felipe-m/oscad_filter_stage/imgs/filter_holder2.png

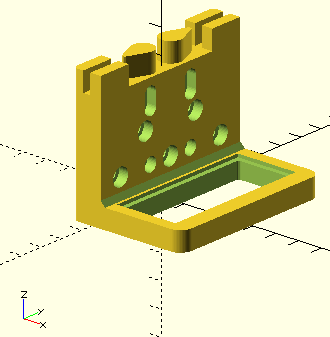
imgs/filter_holder2.png
