felipe-m/oscad_filter_stage/imgs/filter_holder.png

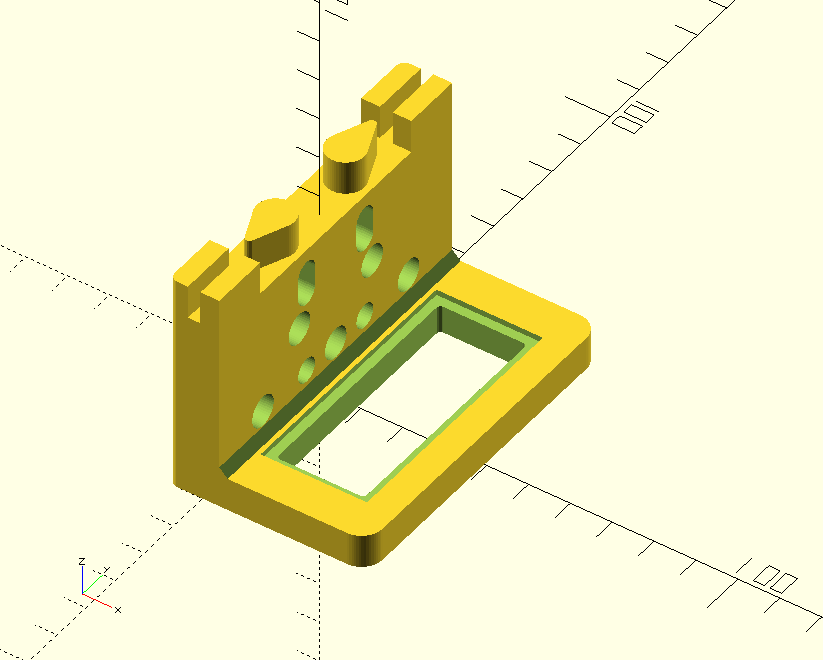
imgs/filter_holder.png
