felipe-m/oscad_filter_stage/imgs/idler_tensioner.png

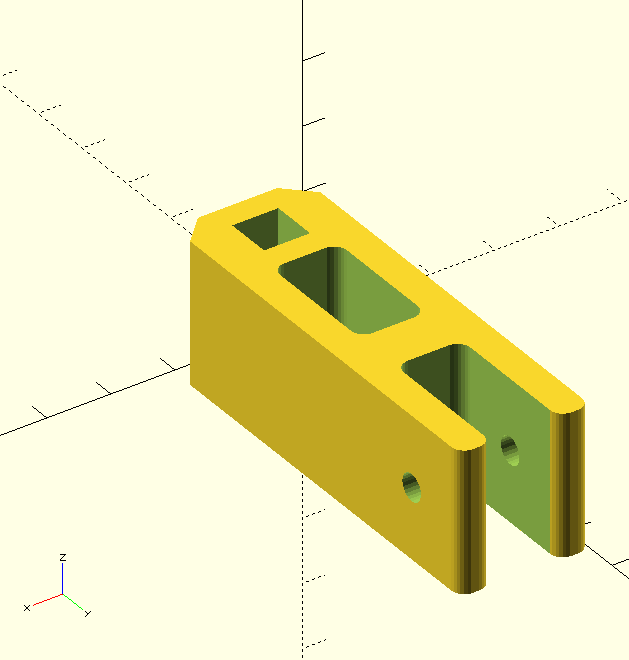
imgs/idler_tensioner.png
