felipe-m/oscad_filter_stage/imgs/idler_tensioner_optional.png

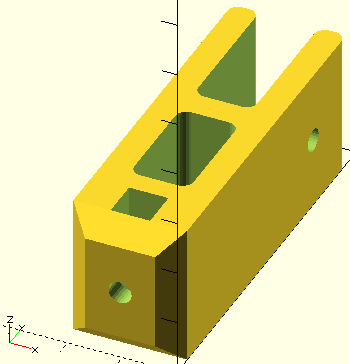
imgs/idler_tensioner_optional.png
