felipe-m/oscad_filter_stage/imgs/nema17holder.png

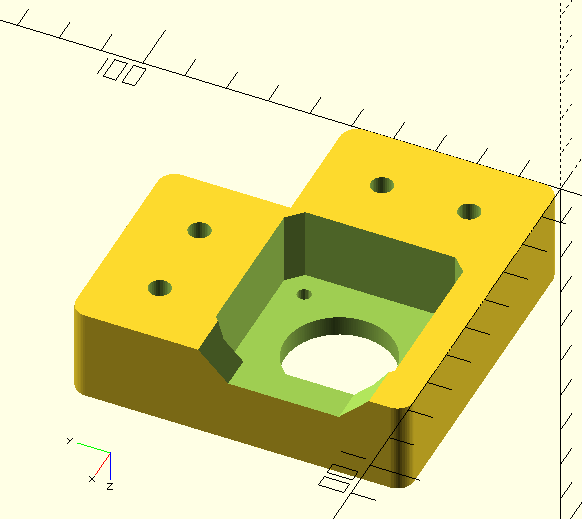
imgs/nema17holder.png
