felipe-m/oscad_filter_stage/imgs/small/nema17holder.png

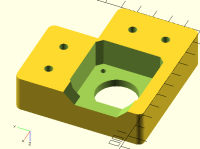
imgs/small/nema17holder.png
