felipe-m/oscad_filter_stage/imgs/tens_holder.png

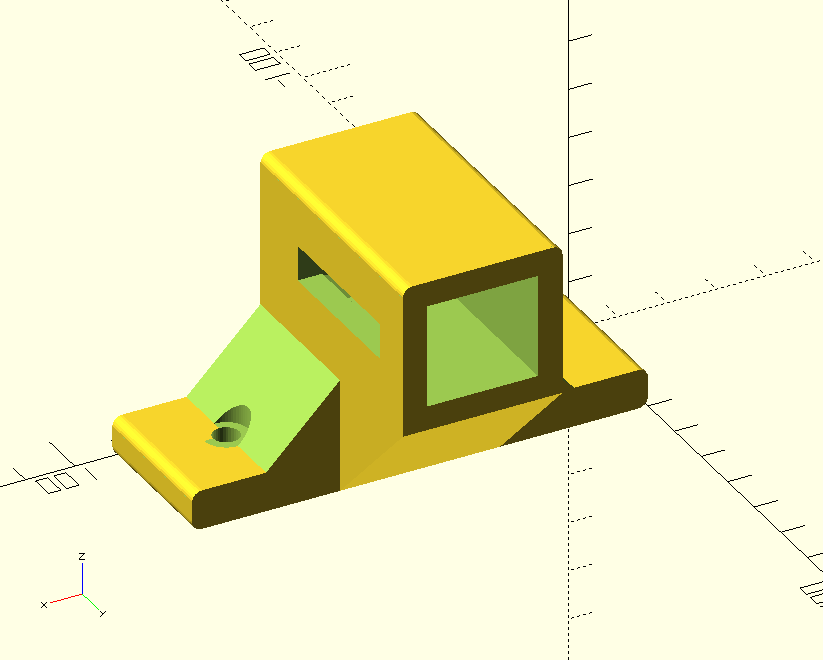
imgs/tens_holder.png
