felipe-m/oscad_filter_stage/stl/nemamotor_holder.stl

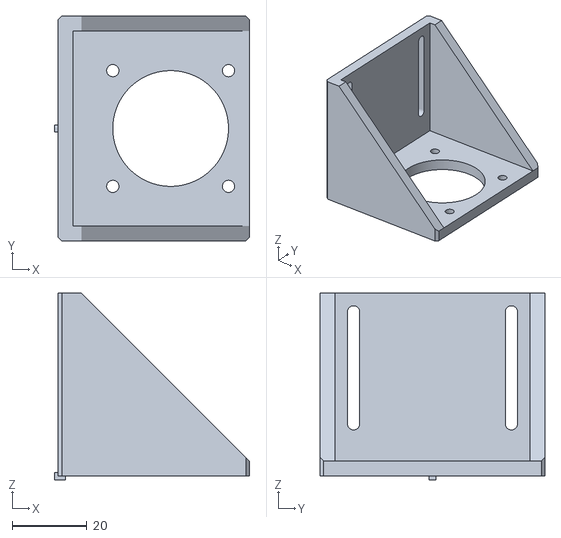
[picture p39: CAD file, 2019-07-27]
stl/nemamotor_holder.stl
52.3 x 60.3 x 50.0
