felipe-m/oscad_filter_stage/stl/idler_tensioner.stl

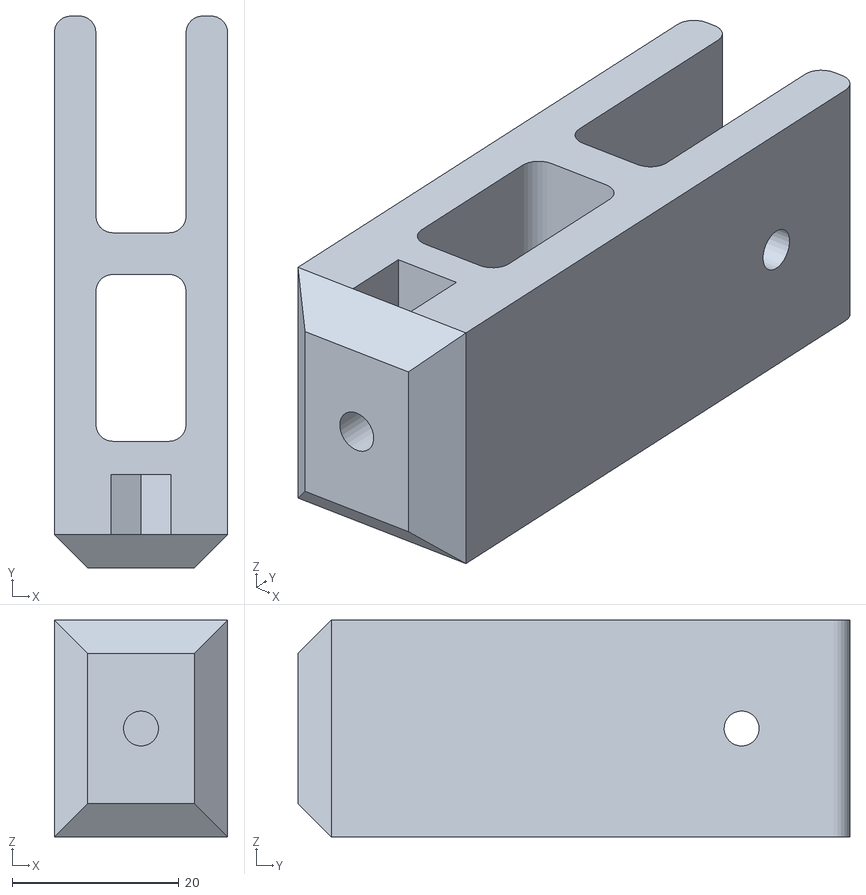
[picture p40: CAD file, 2017-12-09]
stl/idler_tensioner.stl
20.8 x 66.2 x 26.0
