felipe-m/oscad_filter_stage/stl/idler_holder.stl

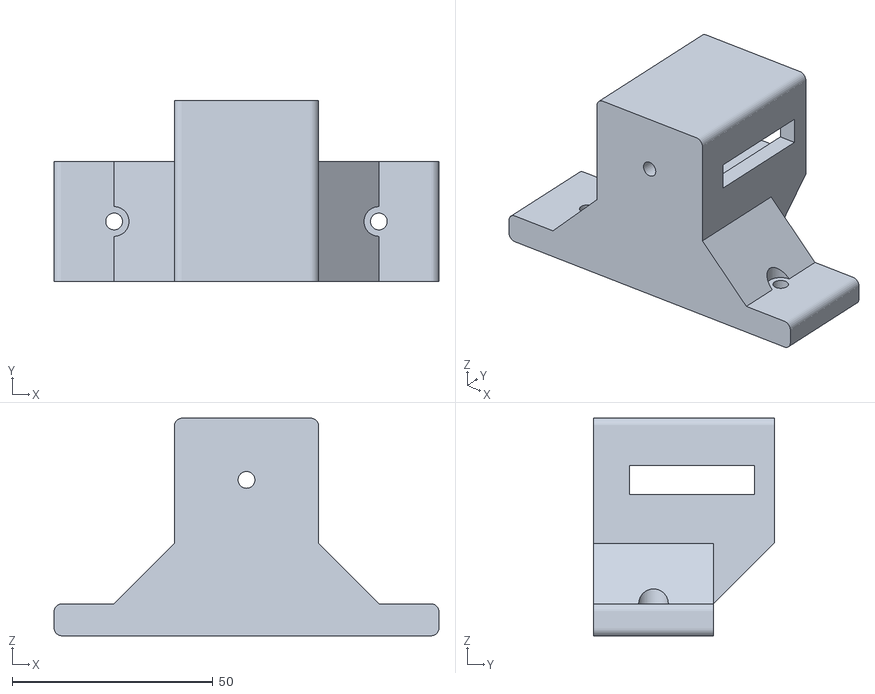
[picture p41: CAD file, 2017-12-09]
stl/idler_holder.stl
96.0 x 45.2 x 54.3
