felipe-m/oscad_filter_stage/stl/filter_holder.stl

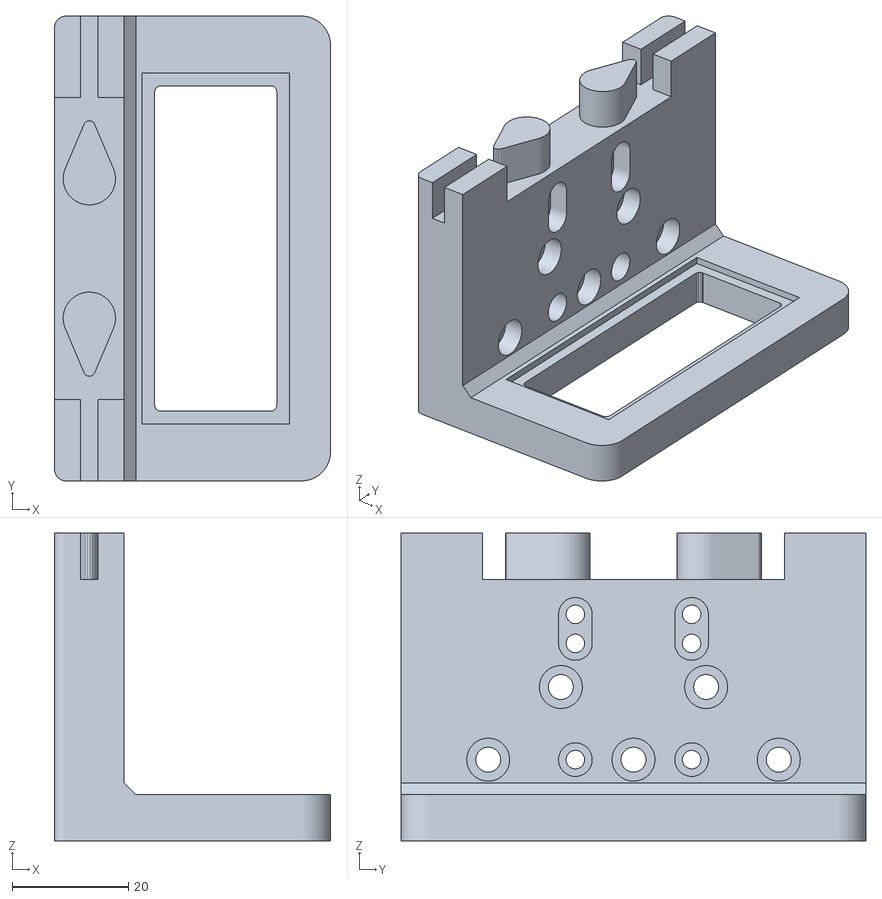
[picture p42: CAD file, 2017-11-26]
stl/filter_holder.stl
47.5 x 80.0 x 53.0
