felipe-m/oscad_filter_stage/src/kidler.scad

/* Idler pulley tensioner and holder constants
  ----------------------------------------------------------------------------
  -- (c) Felipe Machado
  -- Area of Electronic Technology. Rey Juan Carlos University (urjc.es)
  -- https://github.com/felipe-m
  -- December-2017
  ----------------------------------------------------------------------------
  --- LGPL Licence
  ----------------------------------------------------------------------------*/


include <oscad_utils/bolt_sizes.scad> // include to use the constants
use <oscad_utils/bolts.scad>  


// -----------------------------------------------------------------------
// ----------- variables that can be changed -----------------------------

// Thickness of the walls
wall_thick = 5;

/*  Length of the ilder tensioner body, the stroke. Not including the pulley
    See step 06 in ilder_tensioner.scad
           Z
           :
           : ______________________
            /      _____     __:_:_|
           |      /     \   /             
           |     |       | |        
           |      \_____/   \______
            \__________________:_:_|.............> Y
           :     :       :         :
           :     :.......:         :
           :     :   +             :
           :.....:  tens_stroke    :
           :  +                    :
           : nut_holder_total      :
           :                       :
           :...... tens_l .........:
*/

tens_stroke = 20;


// distance between the pulley and the stroke
pulley_stroke_dist = wall_thick;

/* plastic space above and bellow the nut for the screw
   See step 08 in idler_tensioner.scad

           Z
           :
           : ______________________
            /      _____     __:_:_|
           |  _   /     \   /
           |:|_|:|       | |
           |      \_____/   \______
            \__________________:_:_|.............> Y
           : :   :                 :
           :+    :                 :
           :nut_holder_thick       :
           :.....:                 :
           :  +                    :
           : nut_holder_total      :
           :                       :
           :...... tens_l .........:
*/                      
nut_holder_thick = 4;

// inner fillet radius
in_fillet = 2;

// width of the aluminum profiles
aluprof_w = 30;

// bolt size to attach the piece to the aluminum profile
boltaluprof_d = 4;

/* height of the holder base

                               _______        :      :______________
                              |  ___  |       :      |  __________  |
                              | |   | |       :      | |__________| |
                             /| |___| |\      :      |________      |
                            / |_______| \     :      |        |    /      
                    .. ____/  |       |  \____:      |________|  /
        hold_bas_h.+..|_::____|_______|____::_|      |___::___|/......Y
*/
hold_bas_h = 8;

// optional tensioner chamfer, see
// - step 04b in idler_tensioner.scad
// - step 06 in idler_holder.scad
opt_tens_chmf = 1;

// if you want to have the hole at the idler_holder to see inside, on one
// side, or both sides see:
// - step 07 in idler_holder.scad:
hold_hole_2sides = 1;

// The position where the belt starts, from the lower profile
// Considering that the filter holder and guide are in a higher
// aluminum profile than the filter_idler. See picture below

belt_pos_h = aluprof_w + 3.5;




// -----------------------------------------------------------------------
// ---- no changes under this line here unless you know what you are doing ---

// Height of the idler pulley group:
// - washer M6 DIN-9021
// - washer M4 DIN-125
// - bearing 624ZZ
// - washer M4 DIN-125
// - washer M6 DIN-9021
idler_h     = 10.8;  // no need for tolerance. In case of that idler group
//radius of the idler pulley 6mm DIN 9021 washer, the wider ones)
idler_r     = m6_wash9021_or;  // or: outer radius
idler_r_xtr = idler_r + 2;  // +2: a little bit larger

// height, thickness of the M6 DIN-9021 washer
largewasher_thick = 1.6;



// the space for the nut height, will be get multipliying this multiplier by
// the nut height 
nut_space_h_mult = 1.8;
nut_space = nut_space_h_mult * m4_nut_h_tol;
nut_holder_total = nut_space + 2*nut_holder_thick;

// Tensioner dimensions
tens_h = idler_h + 2*wall_thick;
tens_l = (   nut_holder_total
          + tens_stroke
          + 2 * idler_r_xtr
          + pulley_stroke_dist) ;
tens_w = 2 * idler_r_xtr; 

tens_w_tol = tens_w + tol;
tens_h_tol = tens_h + tol;


// the shank for the idler pulley, 
boltidler_r_tol = m4_r_tol;
// the screw for tensioning the pulley 
bolttens_r_tol = m4_r_tol;


// cannot do it with if due to the variable scope
boltaluprof_head_r_tol = (boltaluprof_d == 6) ?
                            m6_head_r_tol :
                          ((boltaluprof_d == 5) ?
                            m5_head_r_tol :
                          ((boltaluprof_d == 4) ?
                            m4_head_r_tol : m3_head_r_tol ));

// cannot do it with if due to the variable scope
boltaluprof_r_tol = (boltaluprof_d == 6) ?
                            m6_r_tol :
                          ((boltaluprof_d == 5) ?
                            m5_r_tol :
                          ((boltaluprof_d == 4) ?
                            m4_r_tol : m3_r_tol ));

// cannot do it with if due to the variable scope
boltaluprof_head_l = (boltaluprof_d == 6) ?
                            m6_head_l :
                          ((boltaluprof_d == 5) ?
                            m5_head_l :
                          ((boltaluprof_d == 4) ?
                            m4_head_l : m3_head_l ));

/* this is useless in openscad because of the variable scope
   the variables are not updated after the conditions
   so we use the conditional above: ?
if (boltaluprof_d == 6) {
  boltaluprof_head_r_tol = m6_head_r_tol;
  boltaluprof_r_tol = m6_r_tol;
  boltaluprof_head_l = m6_head_l;
} else {
  if (boltaluprof_d == 5) {
    boltaluprof_head_r_tol = m5_head_r_tol;
    boltaluprof_r_tol = m5_r_tol;
    boltaluprof_head_l = m5_head_l;
    echo(boltaluprof_r_tol);
  } else {
    if (boltaluprof_d == 4) {
      boltaluprof_head_r_tol = m4_head_r_tol;
      boltaluprof_r_tol = m4_r_tol;
      boltaluprof_head_l = m4_head_l;
    } else {
      boltaluprof_head_r_tol = m3_head_r_tol;
      boltaluprof_r_tol = m3_r_tol;
      boltaluprof_head_l = m3_head_l;
    }
  }
}
*/


/* Vertical position of the belt pulley and the tensioner
                               Z   Z
  idler holder:                :   :
                _______        :   :____________
               /. ___ .\       :   |  ._______ .|
               |.| O |.|       :   |::|_______| |...
              /| |___| |\      :   |  ..........|... tens_h/2 -m4_nut_ap_tol
             / |_______| \     :   |            |  :+tens_pos_h
        ____/__|       |__\____:   |________   /   :  ...
    X..(_______|_______|_______)   |________|/.....:.....hold_bas_h

   idler_tensioner:
          _______________________
         /      ______   ___::___|
        |  __  |      | |
        |:|  |:|      | |         .......................
        |  --  |______| |_======_  = largewasher_thick  :
         \__________________::___|.: wall_thick         :
                                     :                  :
                                     :                  + belt_pos_h
                                     :                  :
                                     +tens_pos_h        :
                                     :                  :
                                     :                  :
                    _________________:__________________:____
                            alu_prof
*/

tens_pos_h = belt_pos_h - wall_thick -largewasher_thick; 

// The part of the tensioner that will be inside
tens_l_inside = tens_l - 2 * idler_r_xtr;

// the height to the beggining of the pulley + pulley height +

hold_w = tens_w + 2*wall_thick;
hold_l = tens_l_inside + wall_thick;
hold_h = tens_pos_h + tens_h + wall_thick;

hold_bas_w = hold_w + 2*aluprof_w;
hold_bas_l = aluprof_w;
