felipe-m/oscad_filter_stage/(list of files, cad)

Other CAD files:
src/idler_holder.scad
src/idler_tensioner.scad
src/tensioner_holder.scad
