felipe-m/oscad_filter_stage/imgs/idler_tens_steps/idler_tensioner_xyz_st06.png

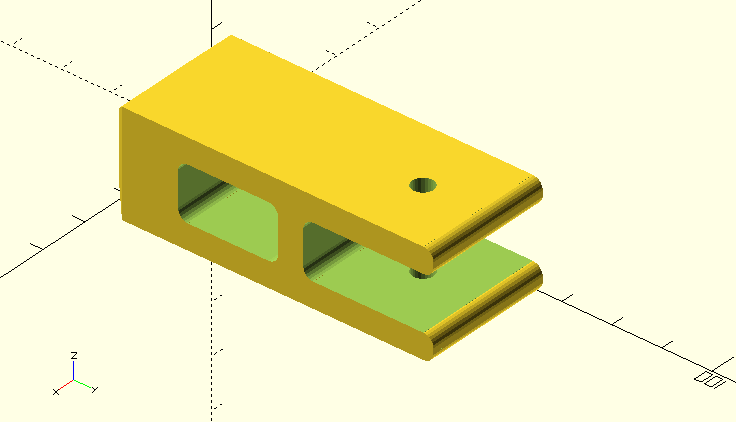
imgs/idler_tens_steps/idler_tensioner_xyz_st06.png
