felipe-m/oscad_filter_stage/imgs/idler_tens_steps/idler_tensioner_yz_st02.png

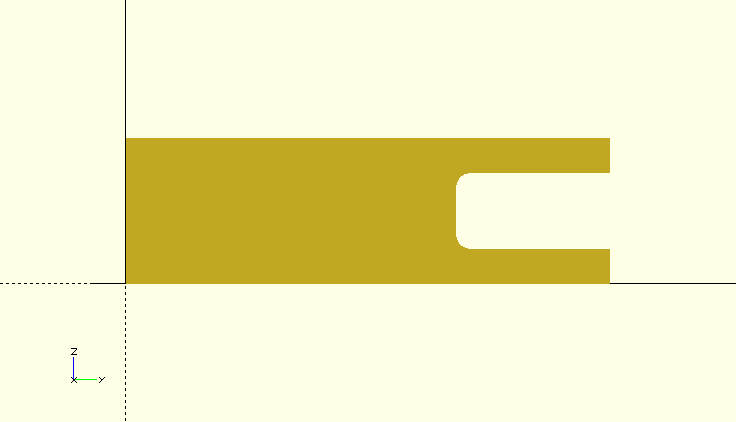
imgs/idler_tens_steps/idler_tensioner_yz_st02.png
