felipe-m/oscad_filter_stage/imgs/small/idler_tens_steps/idler_tensioner_xy_st04b.png

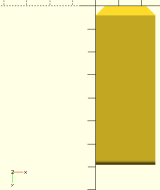
imgs/small/idler_tens_steps/idler_tensioner_xy_st04b.png
