felipe-m/oscad_filter_stage/imgs/tens_hold_steps/tens_hold_xyz_st01.png

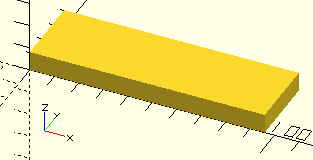
imgs/tens_hold_steps/tens_hold_xyz_st01.png
