felipe-m/oscad_filter_stage/imgs/tens_hold_steps/tens_hold_xz_st04.png

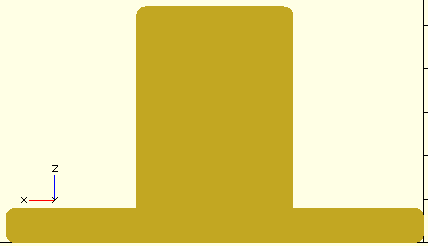
imgs/tens_hold_steps/tens_hold_xz_st04.png
