felipe-m/oscad_filter_stage/imgs/tens_hold_steps/tens_hold_yz_st08_a.png

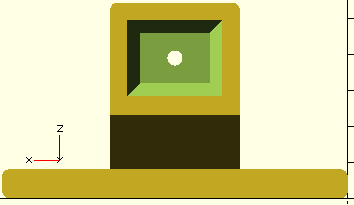
imgs/tens_hold_steps/tens_hold_yz_st08_a.png
