felipe-m/oscad_filter_stage/(commit log)

2017-11-26 Initial commit without oscad_utils
    [filter_holder.scad, filter_holder.stl, idler_cte.scad, idler_holder.scad, idler_holder.stl, idler_tensioner.scad, idler_tensioner.stl, nema17holder.scad]
2017-11-26 Squashed 'scr/oscad_utils/' content from commit d484c5b
    git-subtree-dir: scr/oscad_utils
    git-subtree-split: d484c5b52e85a9d6a7d5191c1b00971642a53ffb
    [bolt_sizes.scad, bolts.scad, chamfer.scad, fillet.scad]
2017-12-09 Modify and comment idler_holder & idler_tensioner
    Change folder name from scr to src
    src/idler_holder.scad:
    src/idler_tensioner.scad:
    src/idler_cte.scad:
    Add detailed explanations
    Modifiy variable names
    idler_holder.md:
    idler_tensioner.md:
    Add tutorials and images
    [bolt_sizes.scad, bolts.scad, chamfer.scad, fillet.scad, filter_holder.scad, idler_cte.scad, idler_holder.scad, idler_holder.stl]
2017-12-09 Minor changes and delete scr folder
    [bolt_sizes.scad, bolts.scad, chamfer.scad, fillet.scad, filter_holder.scad, idler_cte.scad, idler_holder.scad, idler_tensioner.scad]
2017-12-10 Organize and document the file for the constants
    src/idler_cte.scad is better documented to know which constants can
    be modified
    [idler_cte.scad]
2017-12-10 Move idler_cte.scad to kidler.scad
    src/idler_tensioner.scad: bug corrected at step05, cylinder height
    [idler_holder.scad, idler_tensioner.scad, kidler.scad]
2017-12-13 Change name from idler_holder to tensioner_holder
    Change in the source files, images and markdown
    [idler_cte.scad, idler_tensioner.scad, tensioner_holder.scad]
2017-12-15 Include references to the FreeCAD design
    [tensioner_holder.scad]
2017-12-16 Change variable names
    belt_pos_h -> gt2_pos_h
    aluprof_bolt_d -> boltaluprof_d
    [kidler.scad, tensioner_holder.scad]
2018-02-11 Add english comments and change variable names
    [filter_holder.scad, tensioner_holder.scad]
2018-02-11 Add more comments and variable name changes
    filter_holder.scad
    [filter_holder.scad]
2018-02-18 Variable name change and documentation
    [filter_holder.scad]
2018-02-18 Modify variable names and making more parametric
    [filter_holder.scad]
2018-02-18 Modify variable names and comments
    [filter_holder.scad]
2018-08-18 Add filter holder image
2019-07-14 Have special variables defined outside
    To be able to modify them to test for speed and precision of facets
    [bolt_sizes.scad, bolts.scad, chamfer.scad, fillet.scad, filter_holder.scad]
2019-07-27 Fix a bug of a comma in line 37
    [fillet.scad]
2019-07-27 Add openscad source for the nema motor holder
    And the resulting STL file
    [nemamotor_holder.scad, nemamotor_holder.stl]
